talalbarakatt/Embedded-Systems-4WD-Car.-pic-16F877A/Car pic 2.jpeg

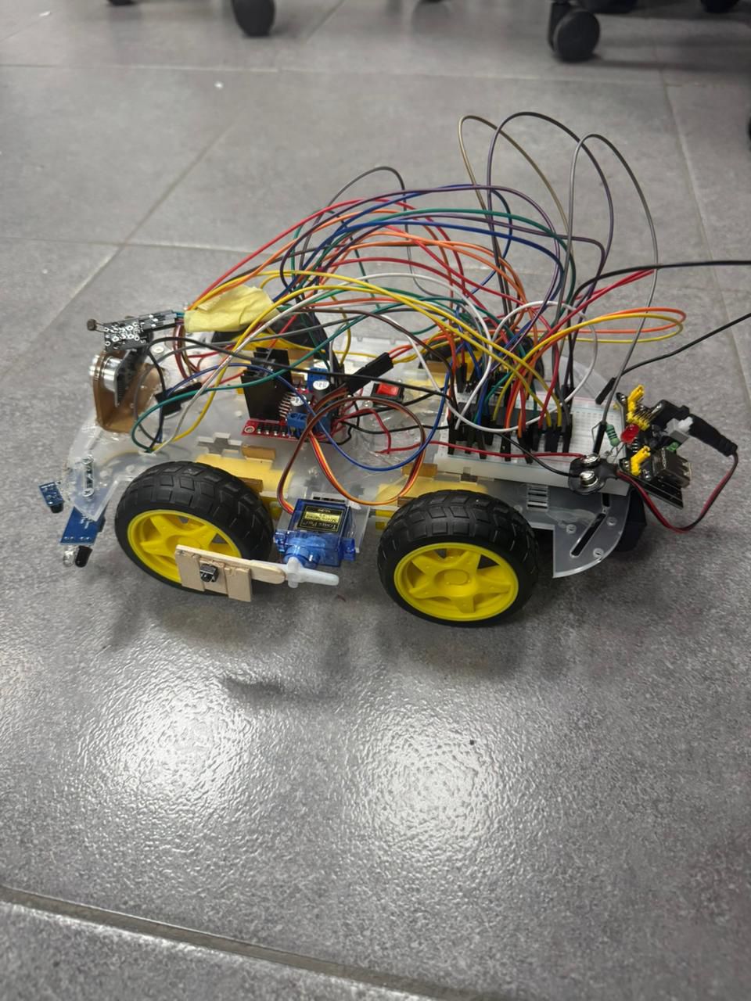
Car pic 2.jpeg
