talalbarakatt/Embedded-Systems-4WD-Car.-pic-16F877A/Car pic.jpeg

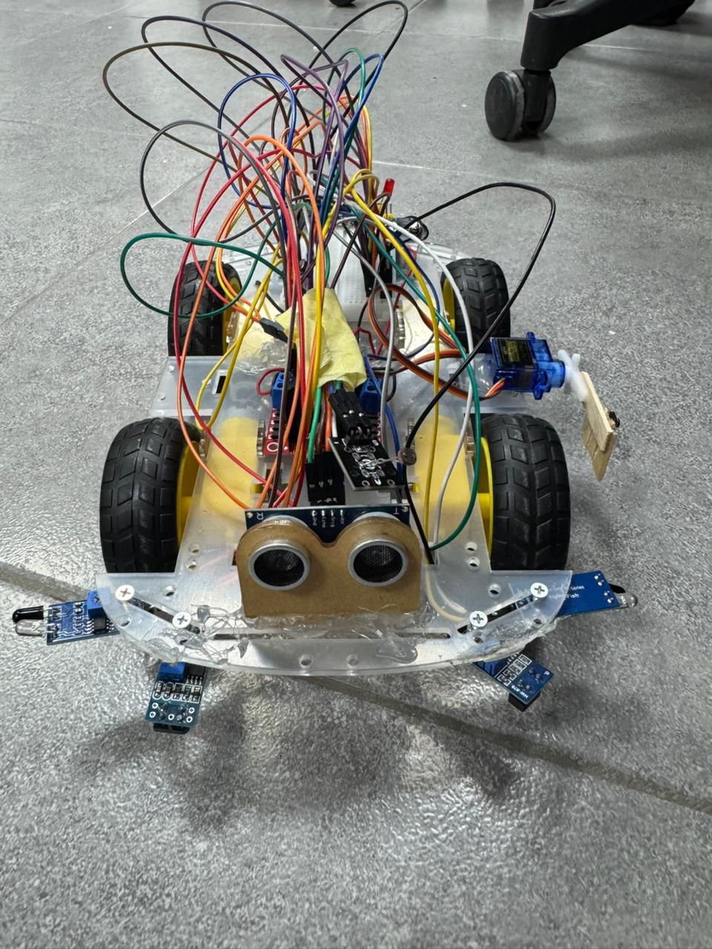
Car pic.jpeg
