talalbarakatt/Embedded-Systems-4WD-Car.-pic-16F877A/(commit log)

2026-01-14 Entire Project on mikroC
    [embeddedproj_15.cfg]
2026-01-14 Flowcharts, report, poster, car imgaes
